Joao-Strelow/alerta-sons-esp32/4-ia/modelo/grafico_treino.png

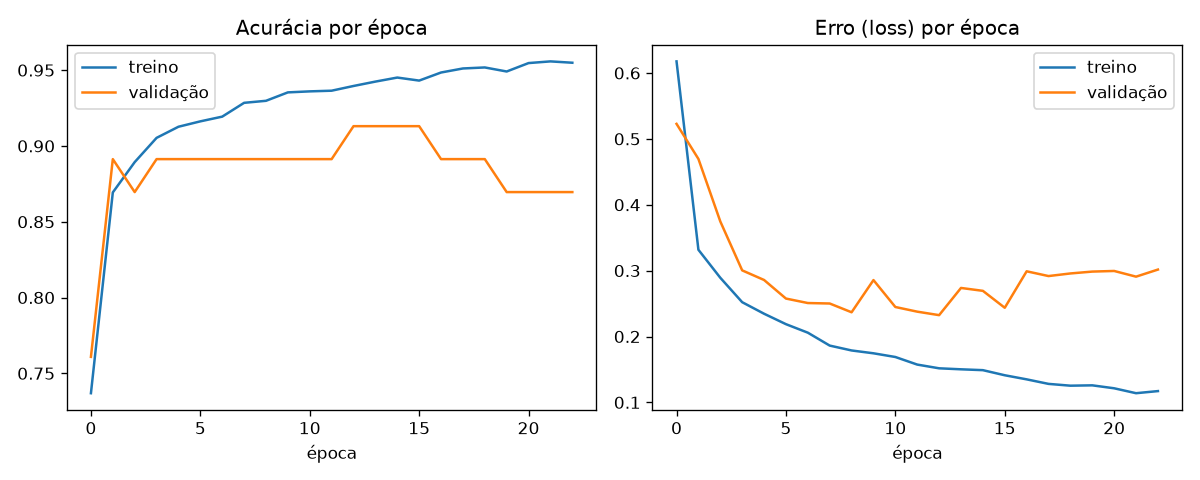
4-ia/modelo/grafico_treino.png
