Joao-Strelow/alerta-sons-esp32/4-ia/modelo/matriz_confusao.png

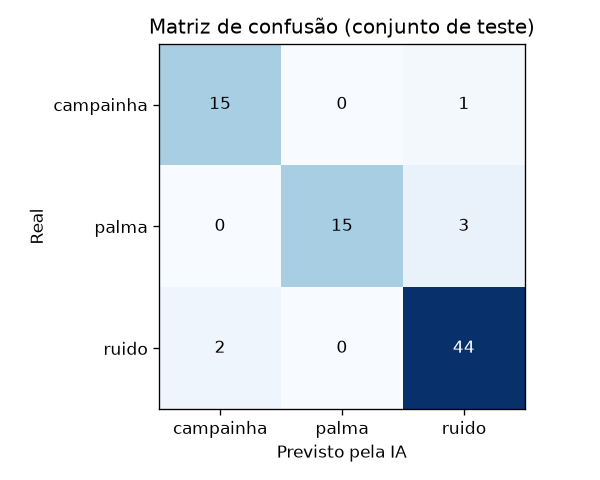
4-ia/modelo/matriz_confusao.png
