Joao-Strelow/alerta-sons-esp32/3-aparelho/alerta-sons-ia/config_features.h

// GERADO AUTOMATICAMENTE por treino/exportar.py - não editar à mão.
// Parâmetros para o ESP32 calcular o espectrograma IGUAL ao do treino em Python.
#pragma once

#define IA_TAXA          16000
#define IA_AMOSTRAS      16000   // 1 segundo de áudio
#define IA_JANELA_FFT    512
#define IA_SALTO         320
#define IA_BANDAS_MEL    32
#define IA_N_BINS        257
#define IA_N_QUADROS     49
#define IA_N_CLASSES     3
#define IA_EPSILON       1e-06f

// Normalização aplicada às features: (x - media) / desvio
static const float IA_MEDIA  = -4.88989592f;
static const float IA_DESVIO = 3.9020381f;

// Conversão float <-> int8 da entrada e da saída do modelo quantizado
static const float IA_ENTRADA_ESCALA = 0.0227481239f;
static const int   IA_ENTRADA_ZERO   = -27;
static const float IA_SAIDA_ESCALA   = 0.00390625f;
static const int   IA_SAIDA_ZERO     = -128;

// Ordem das classes na saída do modelo
static const char* const IA_CLASSES[IA_N_CLASSES] = { "campainha", "palma", "ruido" };

// Janela de Hann (512 valores)
static const float IA_JANELA_HANN[IA_JANELA_FFT] = {
  0.0f, 3.76490789e-05f, 0.000150590655f, 0.000338807702f, 0.000602271874f, 0.000940943544f, 0.00135477167f, 0.0018436939f,
  0.00240763673f, 0.00304651493f, 0.00376023259f, 0.00454868237f, 0.00541174505f, 0.00634929072f, 0.00736117875f, 0.00844725594f,
  0.00960735977f, 0.0108413147f, 0.0121489353f, 0.0135300243f, 0.014984373f, 0.0165117644f, 0.0181119666f, 0.0197847411f,
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
  0.0f, 0.0f, 0.0f, 0.0f, 0.0f, 0.0f, 0.0f, 0.0f,
  0.0f, 0.0f, 0.0f, 0.0f, 0.0f, 0.0f, 0.0f, 0.0f,
  0.0f, 0.0f, 0.0f, 0.0f, 0.0f, 0.0f, 0.0f, 0.0f,
  0.0f, 0.0f, 0.0f, 0.0f, 0.0f, 0.0f, 0.0f, 0.0f,
  0.0f, 0.0f, 0.0f, 0.0f, 0.0f, 0.0f, 0.0f, 0.0f,
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
};
