Joao-Strelow/alerta-sons-esp32/(commit log)

2026-09-30 Estrutura inicial: app Nuxt + firmware ESP32 + schema Supabase
    PWA que recebe eventos de som via Supabase Realtime e mostra alerta
    visual em tela, historico, marcacao de visto e status online/offline
    de cada no, pensado para acessibilidade.
2026-09-30 Corrige erro de compilacao e falta de RAM nas chamadas de rede
    setBufferSizes nao existe na versao do core ESP32 em uso. Em vez disso,
    pausa a captura de audio e serializa com um mutex as duas chamadas
    HTTPS (evento e heartbeat), evitando que a classificacao contigua de
    memoria rode ao mesmo tempo que uma sessao TLS aberta.
    [alerta-sons-esp32.ino]
2026-09-30 Adiciona diagrama de arquitetura e tecnologias usadas ao README
2026-09-30 Melhora visual do app, adiciona favicon e policy de delete no Supabase
2026-10-07 Alerta em tela fica piscando ate confirmar ou chegar outro evento
    Antes o alerta desaparecia sozinho depois de 2.5s, o que nao da tempo
    garantido para uma pessoa com deficiencia auditiva perceber e reagir.
    Agora ele so fecha quando a pessoa toca em qualquer lugar da tela ou
    no botao 'Confirmar que vi', e isso ja marca o evento como visto.
2026-10-07 Melhora fluidez da interface
    Limita o historico em memoria a 50 eventos (antes crescia sem limite
    em sessoes longas, pesando o DOM), e da dicas de renderizacao ao
    navegador (contain na lista, will-change no alerta piscando) para a
    tela ficar mais fluida.
2026-10-07 Corrige piscada travada do alerta em tela
    A animacao usava steps(2) sobre keyframes que ja eram abruptos, o que
    fazia o pisca ficar serrilhado em vez de um blink limpo. Agora usa
    keyframes com patamares fixos (sem interpolacao no meio) e timing
    linear, o que da um blink solido e mais fluido.
2026-10-07 Alerta pisca por 3s e depois fica fixo na tela
    Piscar para sempre incomodava visualmente. Agora o blink dura so os
    primeiros 3 segundos (chama a atencao), depois a tela fica parada e
    colorida ate a pessoa confirmar ou chegar outro evento.
2026-10-07 Alerta some automaticamente apos 3s
    Volta a fechar sozinho depois de piscar por 3 segundos (marcando como
    visto), em vez de ficar fixo na tela esperando confirmacao manual.
    O botao/toque para confirmar antes do tempo continua funcionando.
2026-10-08 Adiciona alerta no Telegram e WiFi movel (WiFiManager)
    O ESP32 agora e levado para lugares diferentes, entao a rede WiFi nao
    fica mais fixa no codigo: um portal de configuracao (WiFiManager) deixa
    a pessoa escolher a rede do lugar na primeira vez, ou de novo com o
    comando serial 'w'.
    Os alertas tambem chegam no Telegram da pessoa, sem mudar o firmware:
    uma Edge Function do Supabase e chamada automaticamente (Database
    Webhook) a cada evento novo e manda a mensagem pro bot. O app web
    ganhou uma secao simples para colar o chat ID do Telegram uma unica
    vez.
    [alerta-sons-esp32.ino]
2026-11-02 Documenta como adicionar novos tipos de som
2026-11-02 Adiciona manual completo (docs/MANUAL.md) e corrige guia de novos sons
2026-11-08 Reorganiza em pastas numeradas e adiciona app de setup
    - Estrutura 1-banco, 2-site, 3-aparelho, 4-ia (ordem de instalacao)
    - setup.bat/setup.mjs: assistente que valida o Supabase e cria .env e secrets.h
    - Credenciais do firmware movidas para secrets.h (fora do Git)
    - exportar.py copia os .h para o firmware automaticamente
    - READMEs por pasta e 4-ia/GUIA-IA.md (treino e como adicionar sons)
    - Remove info.labels (sobras do Edge Impulse) e atualiza caminhos nos docs
2026-11-09 Setup: detecta a Arduino IDE instalada pela Microsoft Store
    A versao da Store fica em WindowsApps e nao era encontrada pelos caminhos
    fixos. Agora o setup pergunta ao Windows (Get-AppxPackage) e tambem cobre
    a IDE 1.8 classica e os caminhos em Program Files (x86).
2026-11-09 Setup: opcao de editar configuracoes e alternar entre bancos
    - Opcao 3 do menu: ver a configuracao atual (chaves mascaradas), trocar
    URL/chave do Supabase (site, aparelho ou ambos), nome do aparelho e
    envio ao ligar
    - Bancos salvos com nome (.setup-perfis.json, fora do Git) para alternar
    - Avisa quando e preciso reiniciar o site ou regravar o ESP32
    - README: secao sobre mudar a configuracao depois
